uddivert/SAP-U/RAM_Module/74F189SC/SOIC16_9P9X3P9_ONS.step

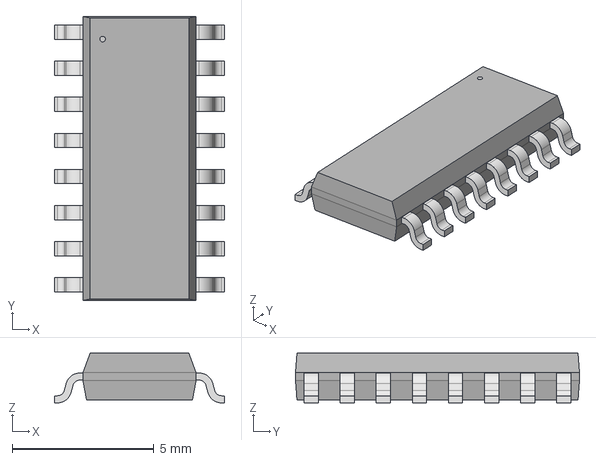
[picture p1: CAD file, 2025-08-04]
RAM_Module/74F189SC/SOIC16_9P9X3P9_ONS.step
6.00 x 10.0 x 1.75 mm
