uddivert/SAP-U/Clock_Module/Clock_Module.kicad_pcb

## KiCad design Clock_Module/Clock_Module.kicad_pcb (2025-07-19)

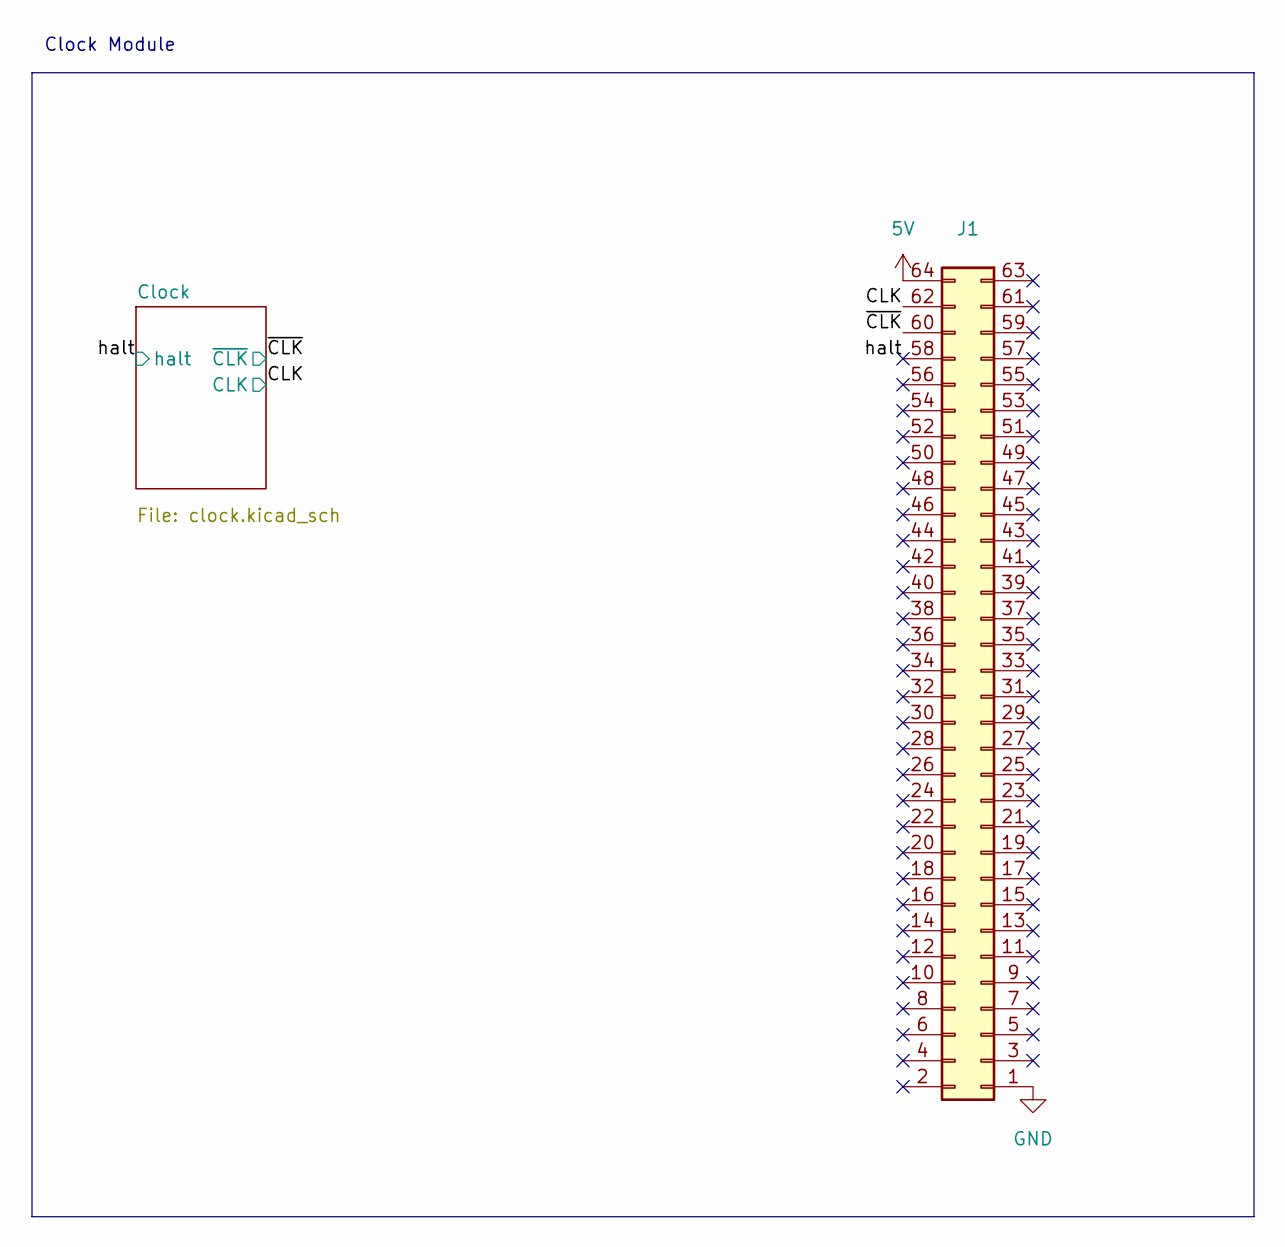
[picture p2: schematic Clock_Module.kicad_sch, Clock Module]

Parts:
J1: PC104-Standard

Connections:
5V: J1.64; also elsewhere on the board
/CLK: J1.62; also elsewhere on the board
/halt: J1.58; also elsewhere on the board
/~CLK: J1.60; also elsewhere on the board
GND: J1.1; also elsewhere on the board

Notes on the sheet:
Clock Module

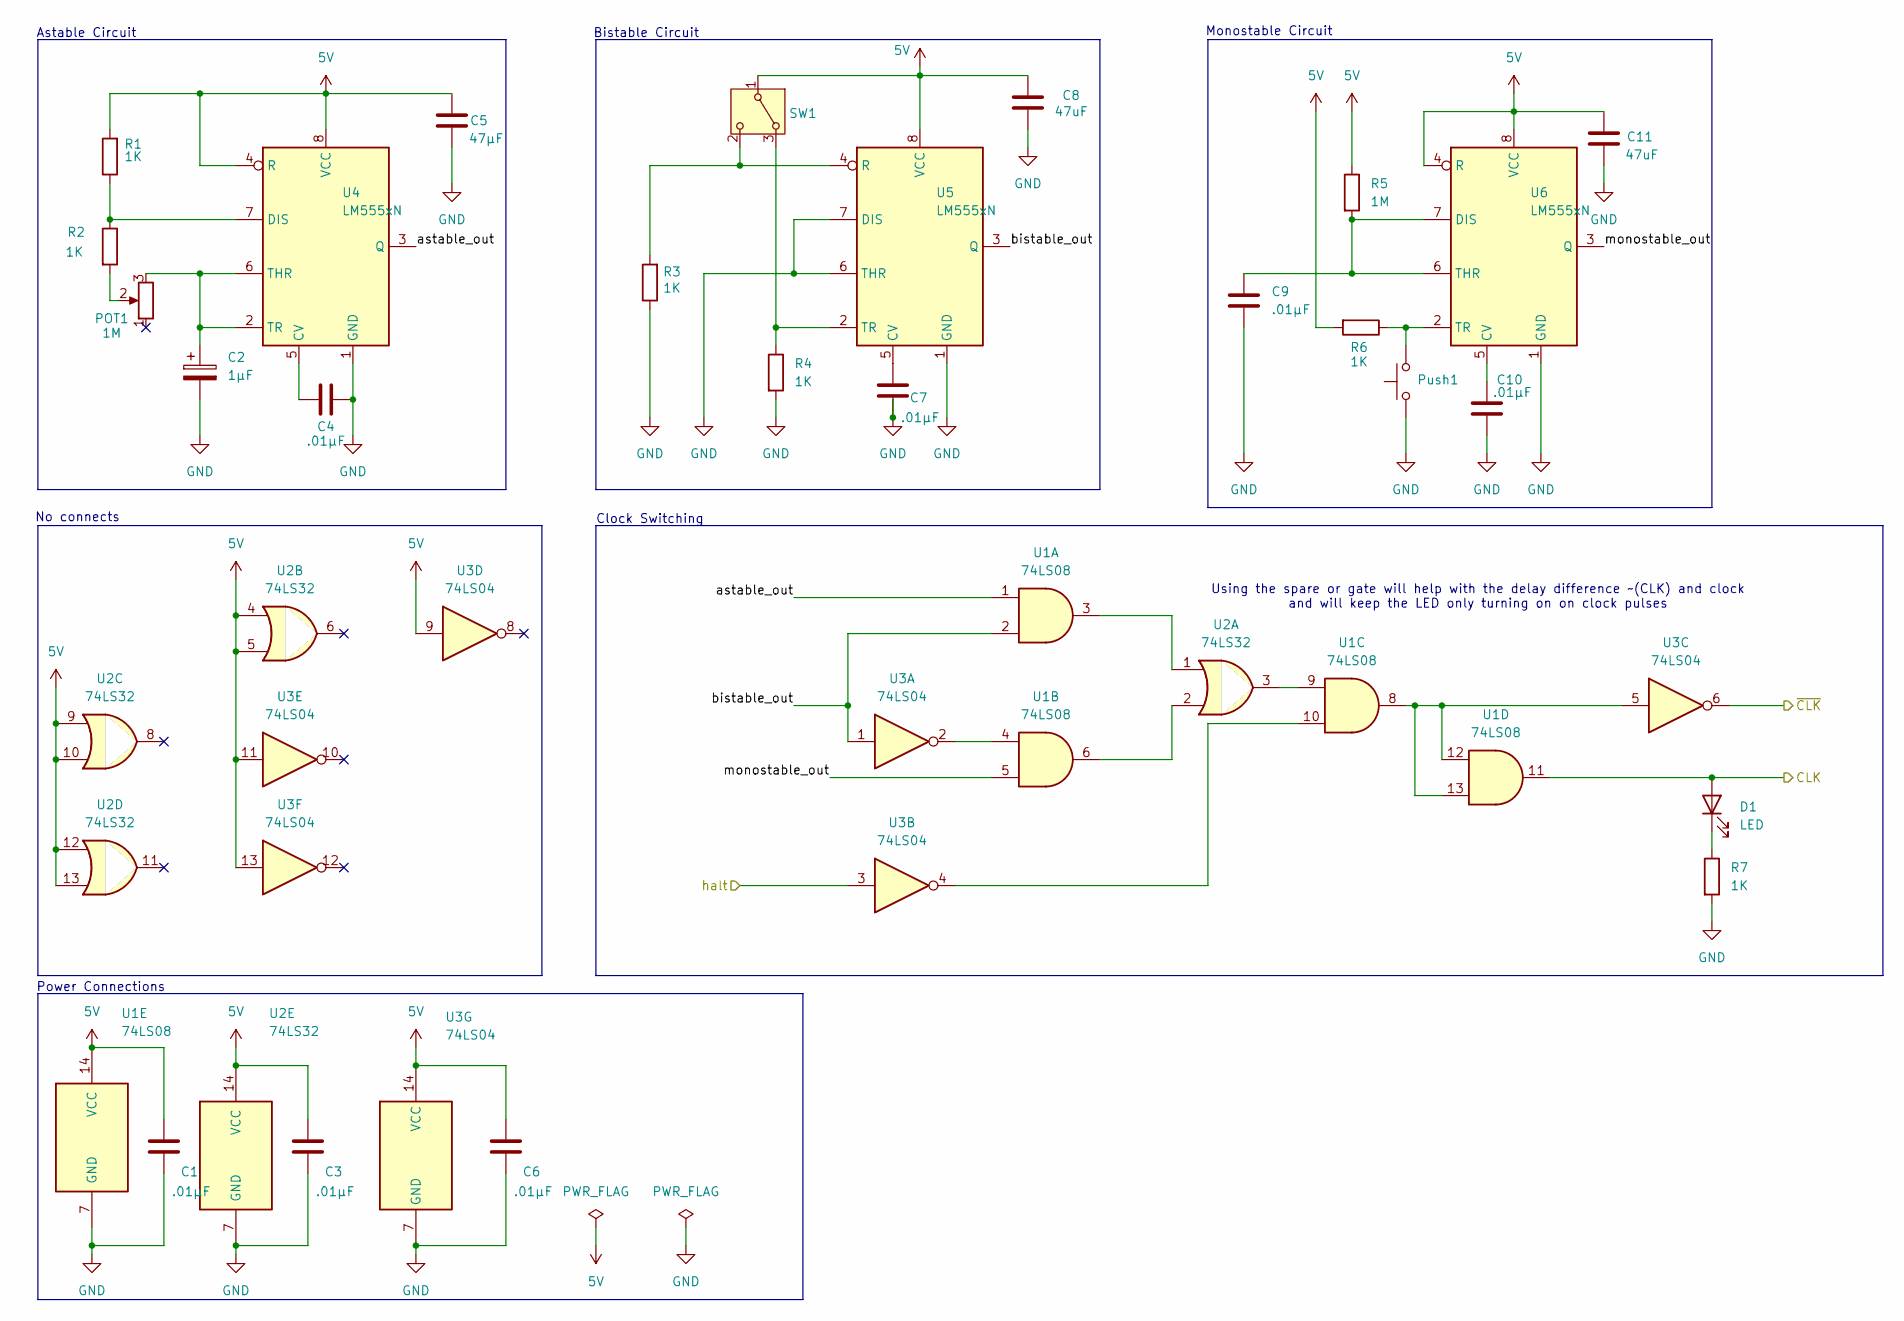
[picture p3: schematic clock.kicad_sch, Clock Logic]

Parts:
C1, C3, C4, C6, C7, C9, C10: .01µF; C_Disc_D5.0mm_W2.5mm_P2.50mm
C2: 1µF; C_Radial_D5.0mm_H11.0mm_P2.00mm
C5: 47µF; C_Disc_D5.0mm_W2.5mm_P2.50mm
C8, C11: 47uF; C_Disc_D5.0mm_W2.5mm_P2.50mm
D1: LED; LED_D5.0mm
POT1: 1M; Potentiometer_Bourns_3266Y_Vertical
Push1: SW_Push; SW_PUSH_6mm_H4.3mm
R1, R2, R3, R4, R6, R7: 1K; R_Axial_DIN0207_L6.3mm_D2.5mm_P5.08mm_Vertical
R5: 1M; R_Axial_DIN0207_L6.3mm_D2.5mm_P5.08mm_Vertical
SW1: Switch; SW_Slide-Jameco-SS-12E17-G020
U1: 74LS08; SN74LS08N
U2: 74LS32; SN74LS32N
U3: 74LS04; SN74LS04N
U4, U5, U6: LM555xN; DIP-8_W7.62mm

Connections:
5V: C1.2, C3.2, C5.1, C6.2, C8.2, C11.1, R1.2, R5.1, R6.2, SW1.1 (B), U1.14 (VCC), U2.4, U2.5, U2.9, U2.10, U2.12, U2.13, U2.14 (VCC), U3.9, U3.11, U3.13, U3.14 (VCC), U4.4 (R), U4.8 (VCC), U5.8 (VCC), U6.4 (R), U6.8 (VCC); also elsewhere on the board
/CLK: D1.2 (A), U1.11; also elsewhere on the board
/Clock/astable_out: U1.1, U4.3 (Q)
/Clock/bistable_out: U1.2, U3.1, U5.3 (Q)
/Clock/monostable_out: U1.5, U6.3 (Q)
/halt: U3.3; also elsewhere on the board
/~CLK: U3.6; also elsewhere on the board
GND: C1.1, C2.2, C3.1, C4.1, C5.2, C6.1, C7.1, C8.1, C9.1, C10.1, C11.2, Push1.1, R3.1, R4.2, R7.2, U1.7 (GND), U2.7 (GND), U3.7 (GND), U4.1 (GND), U5.1 (GND), U5.6 (THR), U5.7 (DIS), U6.1 (GND); also elsewhere on the board
unnamed: D1.1 (K), R7.1
unnamed: POT1.2, R2.2
unnamed: R4.1, SW1.3 (A), U5.2 (TR)
unnamed: R3.2, SW1.2 (C), U5.4 (R)
unnamed: U1.3, U2.1
unnamed: U1.4, U3.2
unnamed: U1.6, U2.2
unnamed: U1.9, U2.3
unnamed: U1.10, U3.4
unnamed: U1.8, U1.12, U1.13, U3.5
unnamed: C4.2, U4.5 (CV)
unnamed: R1.1, R2.1, U4.7 (DIS)
unnamed: C2.1, POT1.3, U4.2 (TR), U4.6 (THR)
unnamed: C7.2, U5.5 (CV)
unnamed: C10.2, U6.5 (CV)
unnamed: C9.2, R5.2, U6.6 (THR), U6.7 (DIS)
unnamed: Push1.2, R6.1, U6.2 (TR)

Notes on the sheet:
Astable Circuit
Power Connections
Bistable Circuit
Monostable Circuit
Clock Switching
No connects
Using the spare or gate will help with the delay difference ~(CLK) and clock and will keep the LED only turning on on clock pulses

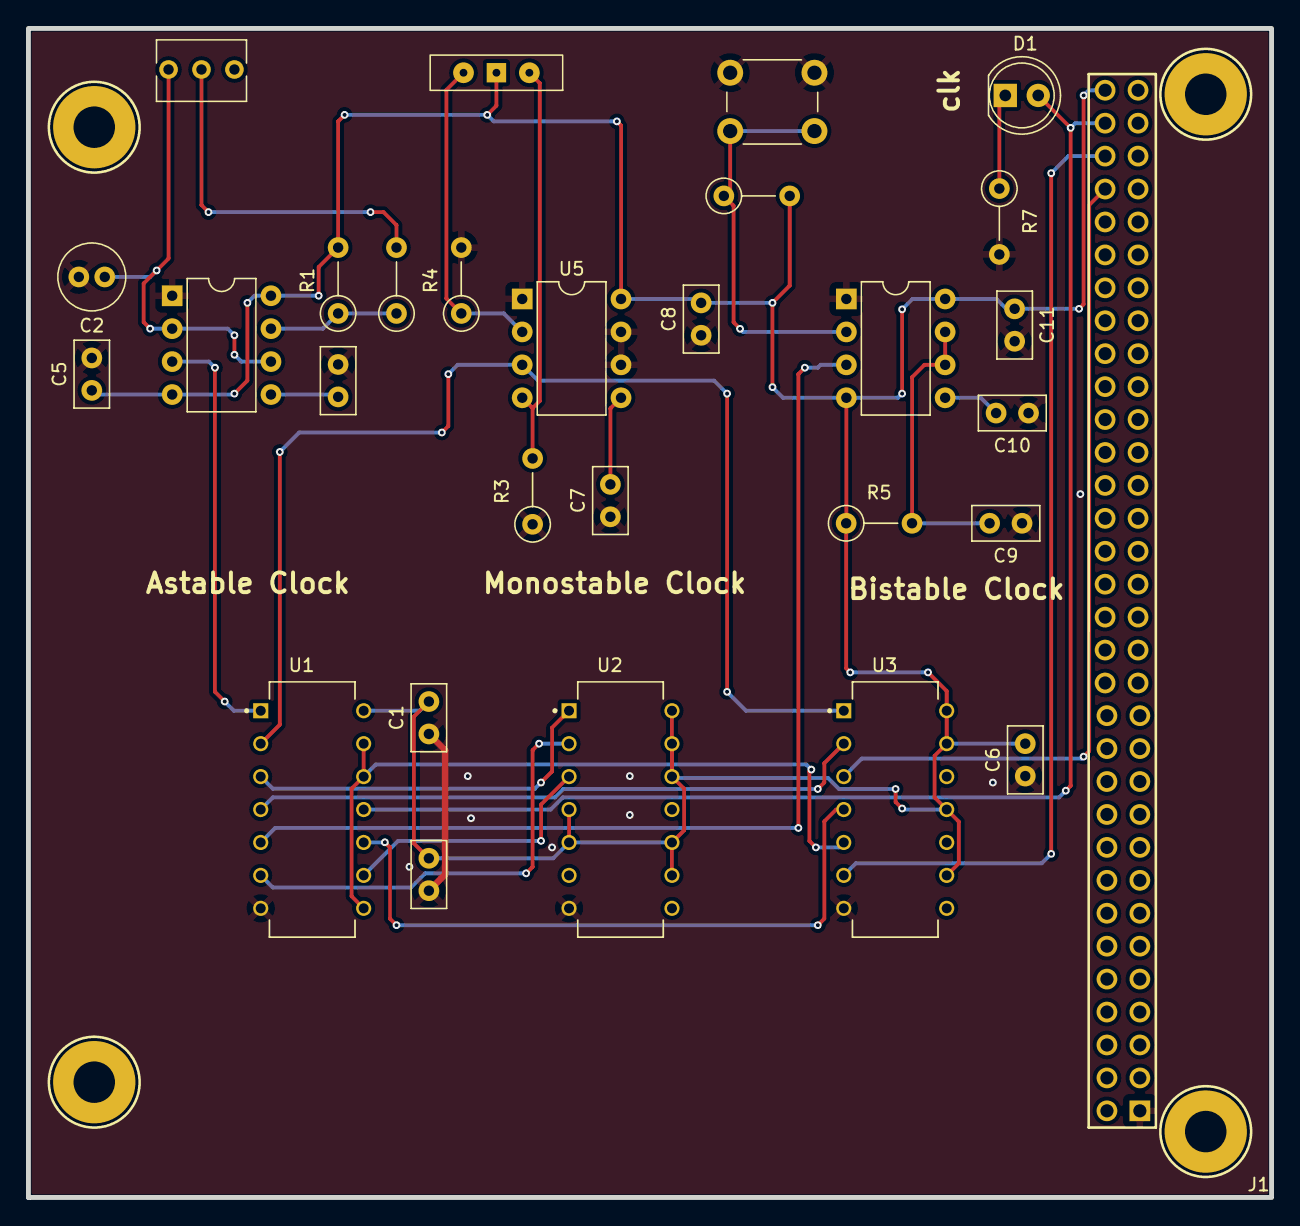
[picture p4: board Clock_Module.kicad_pcb from above]

Board: 2 copper layers, 95.9 x 90.2 mm, 29 parts (0 on the bottom side), 25 nets.
