uddivert/SAP-U/Registers_Module/Registers_Module.kicad_pcb

## KiCad design Registers_Module/Registers_Module.kicad_pcb (2025-07-19)

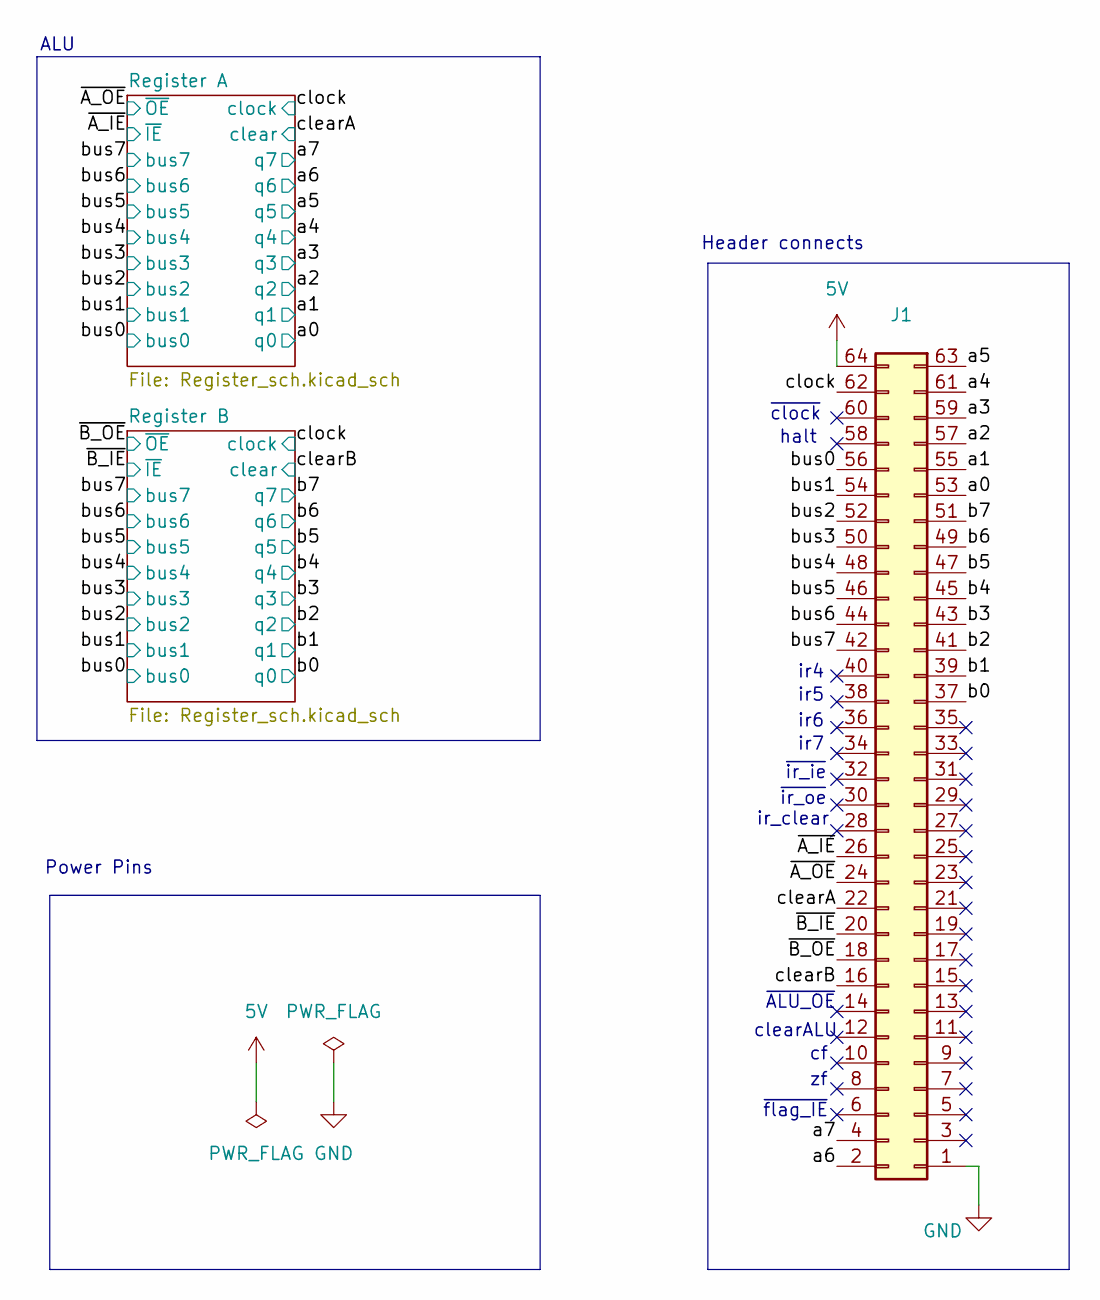
[picture p5: schematic Registers_Module.kicad_sch, Arithmethic Logic Unit]

Parts:
J1: PC104-Standard

Connections:
5V: J1.64; also elsewhere on the board
/a0: J1.53; also elsewhere on the board
/a1: J1.55; also elsewhere on the board
/a2: J1.57; also elsewhere on the board
/a3: J1.59; also elsewhere on the board
/a4: J1.61; also elsewhere on the board
/a5: J1.63; also elsewhere on the board
/a6: J1.2; also elsewhere on the board
/a7: J1.4; also elsewhere on the board
/b0: J1.37; also elsewhere on the board
/b1: J1.39; also elsewhere on the board
/b2: J1.41; also elsewhere on the board
/b3: J1.43; also elsewhere on the board
/b4: J1.45; also elsewhere on the board
/b5: J1.47; also elsewhere on the board
/b6: J1.49; also elsewhere on the board
/b7: J1.51; also elsewhere on the board
/bus0: J1.56; also elsewhere on the board
/bus1: J1.54; also elsewhere on the board
/bus2: J1.52; also elsewhere on the board
/bus3: J1.50; also elsewhere on the board
/bus4: J1.48; also elsewhere on the board
/bus5: J1.46; also elsewhere on the board
/bus6: J1.44; also elsewhere on the board
/bus7: J1.42; also elsewhere on the board
/clearA: J1.22; also elsewhere on the board
/clearB: J1.16; also elsewhere on the board
/clock: J1.62; also elsewhere on the board
/~A_IE: J1.26; also elsewhere on the board
/~A_OE: J1.24; also elsewhere on the board
/~B_IE: J1.20; also elsewhere on the board
/~B_OE: J1.18; also elsewhere on the board
GND: J1.1; also elsewhere on the board

Notes on the sheet:
ir5
ir6
~{ir_ie}
ALU
~{ir_oe}
~{ALU_OE}
ir_clear
halt
~{clock}
ir7
ir4
Header connects
Power Pins
~{flag_IE}
clearALU

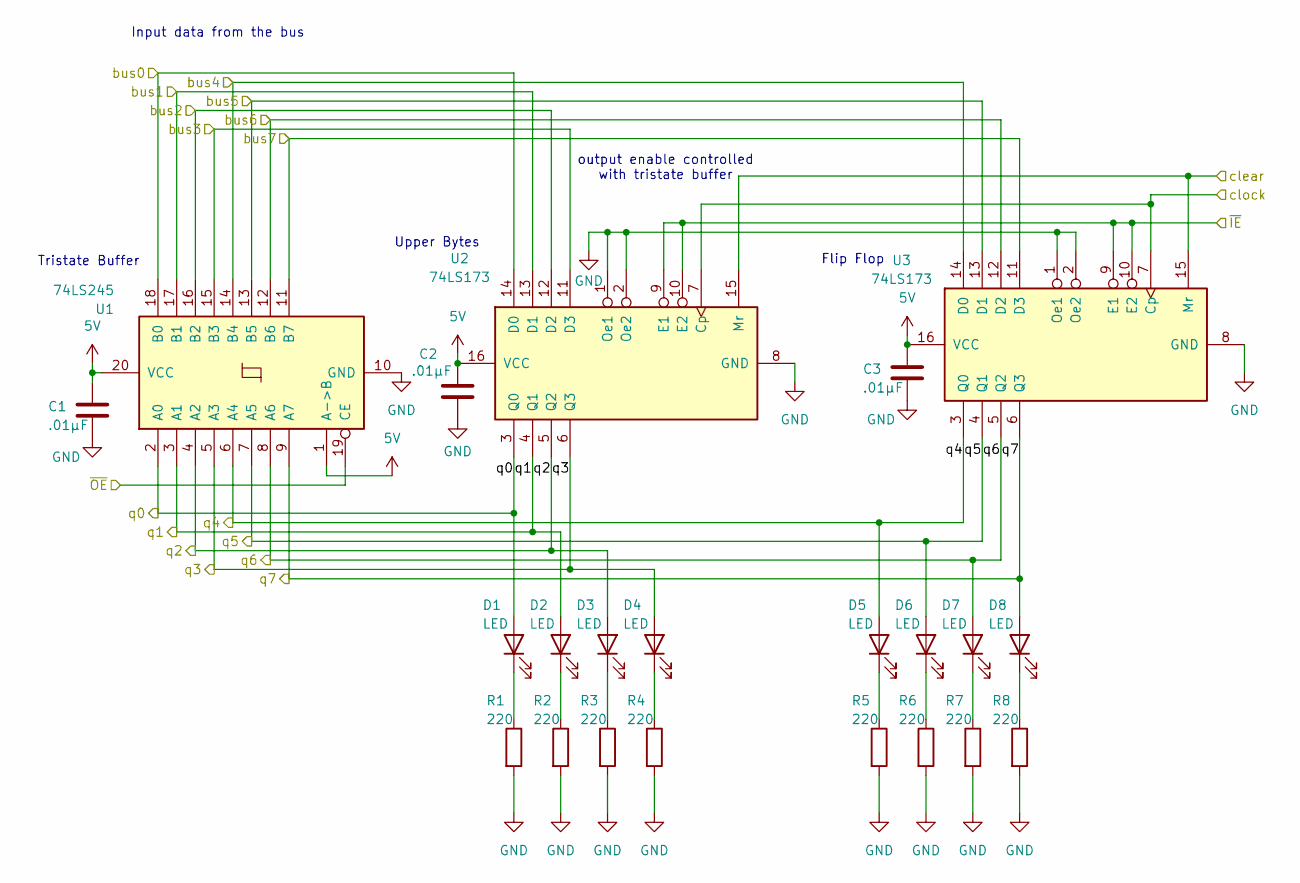
[picture p6: schematic Register_sch.kicad_sch, Registers]

Parts:
C1, C2, C3: .01µF; C_Disc_D5.0mm_W2.5mm_P2.50mm
D1, D2, D3, D4, D5, D6, D7, D8: LED; LED_D5.0mm
R1, R2, R3, R4, R5, R6, R7, R8: 220; R_Axial_DIN0207_L6.3mm_D2.5mm_P5.08mm_Vertical
U1: 74LS245; DIP-20_W7.62mm
U2, U3: 74LS173; DIP-16_W7.62mm

Connections:
5V: C1.2, C2.2, C3.2, U1.1 (A->B), U1.20 (VCC), U2.16 (VCC), U3.16 (VCC); also elsewhere on the board
/a0: D1.2 (A), U1.2 (A0), U2.3 (Q0); also elsewhere on the board
/a1: D2.2 (A), U1.3 (A1), U2.4 (Q1); also elsewhere on the board
/a2: D3.2 (A), U1.4 (A2), U2.5 (Q2); also elsewhere on the board
/a3: D4.2 (A), U1.5 (A3), U2.6 (Q3); also elsewhere on the board
/a4: D5.2 (A), U1.6 (A4), U3.3 (Q0); also elsewhere on the board
/a5: D6.2 (A), U1.7 (A5), U3.4 (Q1); also elsewhere on the board
/a6: D7.2 (A), U1.8 (A6), U3.5 (Q2); also elsewhere on the board
/a7: D8.2 (A), U1.9 (A7), U3.6 (Q3); also elsewhere on the board
/bus0: U1.18 (B0), U2.14 (D0); also elsewhere on the board
/bus1: U1.17 (B1), U2.13 (D1); also elsewhere on the board
/bus2: U1.16 (B2), U2.12 (D2); also elsewhere on the board
/bus3: U1.15 (B3), U2.11 (D3); also elsewhere on the board
/bus4: U1.14 (B4), U3.14 (D0); also elsewhere on the board
/bus5: U1.13 (B5), U3.13 (D1); also elsewhere on the board
/bus6: U1.12 (B6), U3.12 (D2); also elsewhere on the board
/bus7: U1.11 (B7), U3.11 (D3); also elsewhere on the board
/clearA: U2.15 (Mr), U3.15 (Mr); also elsewhere on the board
/clock: U2.7 (Cp), U3.7 (Cp); also elsewhere on the board
/~A_IE: U2.9 (E1), U2.10 (E2), U3.9 (E1), U3.10 (E2); also elsewhere on the board
/~A_OE: U1.19 (CE); also elsewhere on the board
GND: C1.1, C2.1, C3.1, R1.2, R2.2, R3.2, R4.2, R5.2, R6.2, R7.2, R8.2, U1.10 (GND), U2.1 (Oe1), U2.2 (Oe2), U2.8 (GND), U3.1 (Oe1), U3.2 (Oe2), U3.8 (GND); also elsewhere on the board
unnamed: D1.1 (K), R1.1
unnamed: D2.1 (K), R2.1
unnamed: D3.1 (K), R3.1
unnamed: D4.1 (K), R4.1
unnamed: D5.1 (K), R5.1
unnamed: D6.1 (K), R6.1
unnamed: D7.1 (K), R7.1
unnamed: D8.1 (K), R8.1

Parts of its further copies:
C12, C13, C14: .01µF; C_Disc_D5.0mm_W2.5mm_P2.50mm
D17, D18, D19, D20, D21, D22, D23, D24: LED; LED_D5.0mm
R17, R18, R19, R20, R21, R22, R23, R24: 220; R_Axial_DIN0207_L6.3mm_D2.5mm_P5.08mm_Vertical
U12: 74LS245; DIP-20_W7.62mm
U13, U14: 74LS173; DIP-16_W7.62mm

Connections of its further copies:
5V: C12.2, C13.2, C14.2, U12.1 (A->B), U12.20 (VCC), U13.16 (VCC), U14.16 (VCC); also elsewhere on the board
/b0: D17.2 (A), U12.2 (A0), U13.3 (Q0); also elsewhere on the board
/b1: D18.2 (A), U12.3 (A1), U13.4 (Q1); also elsewhere on the board
/b2: D19.2 (A), U12.4 (A2), U13.5 (Q2); also elsewhere on the board
/b3: D20.2 (A), U12.5 (A3), U13.6 (Q3); also elsewhere on the board
/b4: D21.2 (A), U12.6 (A4), U14.3 (Q0); also elsewhere on the board
/b5: D22.2 (A), U12.7 (A5), U14.4 (Q1); also elsewhere on the board
/b6: D23.2 (A), U12.8 (A6), U14.5 (Q2); also elsewhere on the board
/b7: D24.2 (A), U12.9 (A7), U14.6 (Q3); also elsewhere on the board
/bus0: U12.18 (B0), U13.14 (D0); also elsewhere on the board
/bus1: U12.17 (B1), U13.13 (D1); also elsewhere on the board
/bus2: U12.16 (B2), U13.12 (D2); also elsewhere on the board
/bus3: U12.15 (B3), U13.11 (D3); also elsewhere on the board
/bus4: U12.14 (B4), U14.14 (D0); also elsewhere on the board
/bus5: U12.13 (B5), U14.13 (D1); also elsewhere on the board
/bus6: U12.12 (B6), U14.12 (D2); also elsewhere on the board
/bus7: U12.11 (B7), U14.11 (D3); also elsewhere on the board
/clearB: U13.15 (Mr), U14.15 (Mr); also elsewhere on the board
/clock: U13.7 (Cp), U14.7 (Cp); also elsewhere on the board
/~B_IE: U13.9 (E1), U13.10 (E2), U14.9 (E1), U14.10 (E2); also elsewhere on the board
/~B_OE: U12.19 (CE); also elsewhere on the board
GND: C12.1, C13.1, C14.1, R17.2, R18.2, R19.2, R20.2, R21.2, R22.2, R23.2, R24.2, U12.10 (GND), U13.1 (Oe1), U13.2 (Oe2), U13.8 (GND), U14.1 (Oe1), U14.2 (Oe2), U14.8 (GND); also elsewhere on the board
unnamed: D17.1 (K), R17.1
unnamed: D18.1 (K), R18.1
unnamed: D19.1 (K), R19.1
unnamed: D20.1 (K), R20.1
unnamed: D21.1 (K), R21.1
unnamed: D22.1 (K), R22.1
unnamed: D23.1 (K), R23.1
unnamed: D24.1 (K), R24.1

Notes on the sheet:
Upper Bytes
Flip Flop
output enable controlled with tristate buffer
Input data from the bus
Tristate Buffer

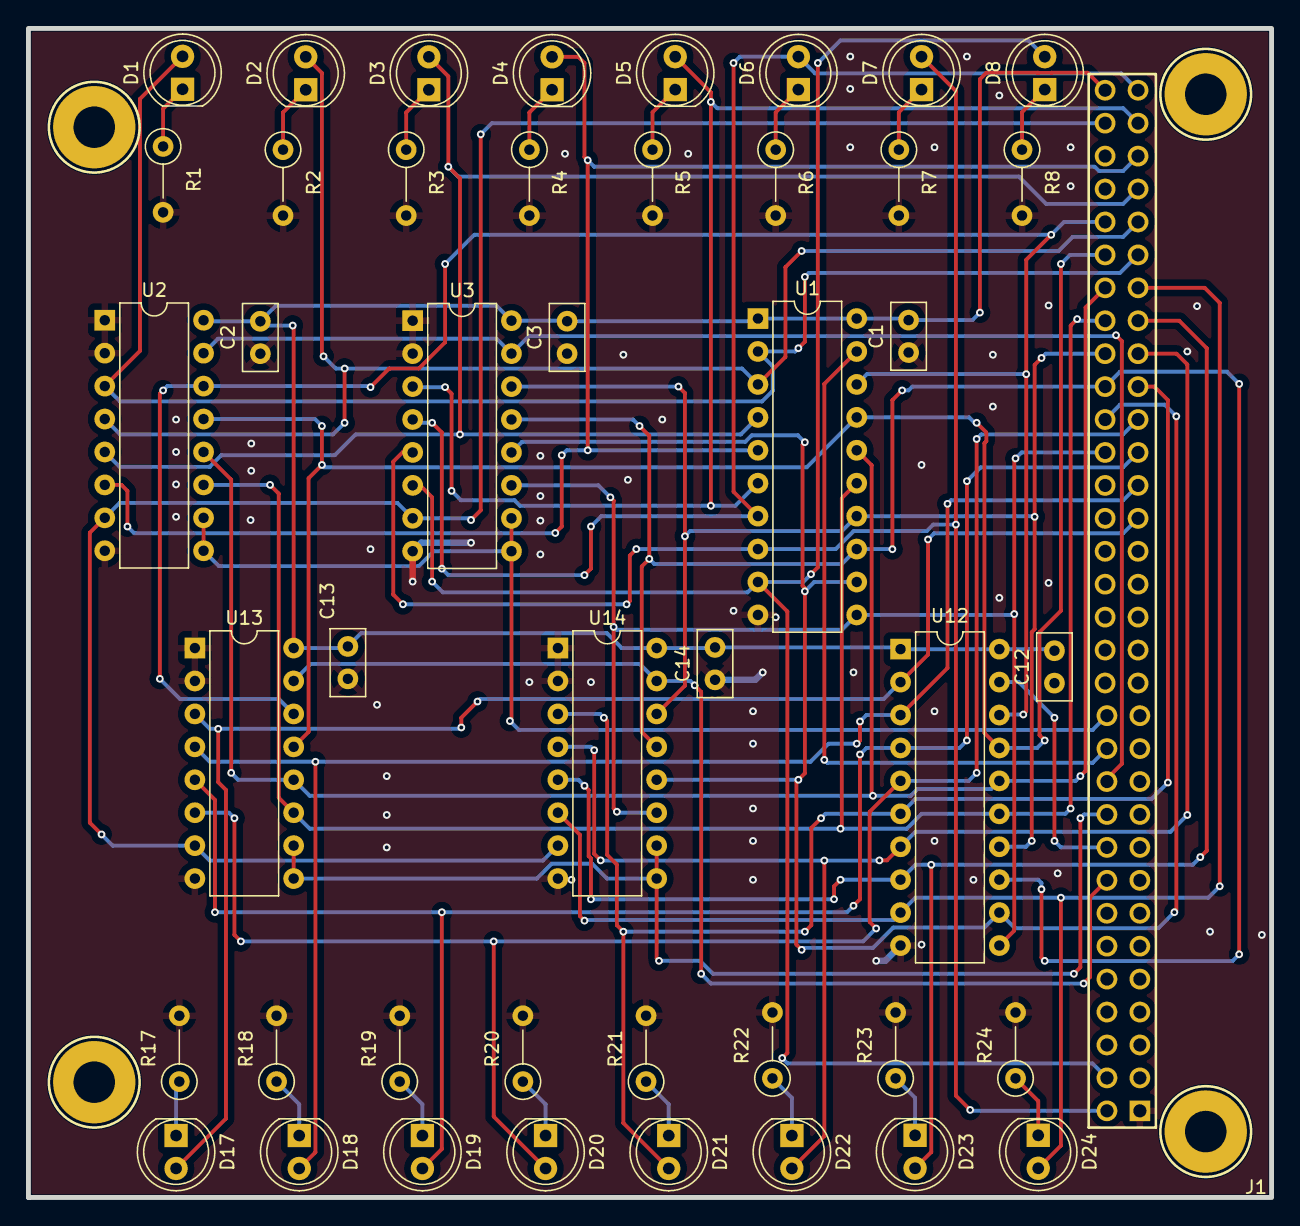
[picture p7: board Registers_Module.kicad_pcb from above]

Board: 2 copper layers, 95.9 x 90.2 mm, 45 parts (0 on the bottom side), 49 nets.
