uddivert/SAP-U/Instruction_Register/Instruction_Register.kicad_pcb

## KiCad design Instruction_Register/Instruction_Register.kicad_pcb (2025-02-03)

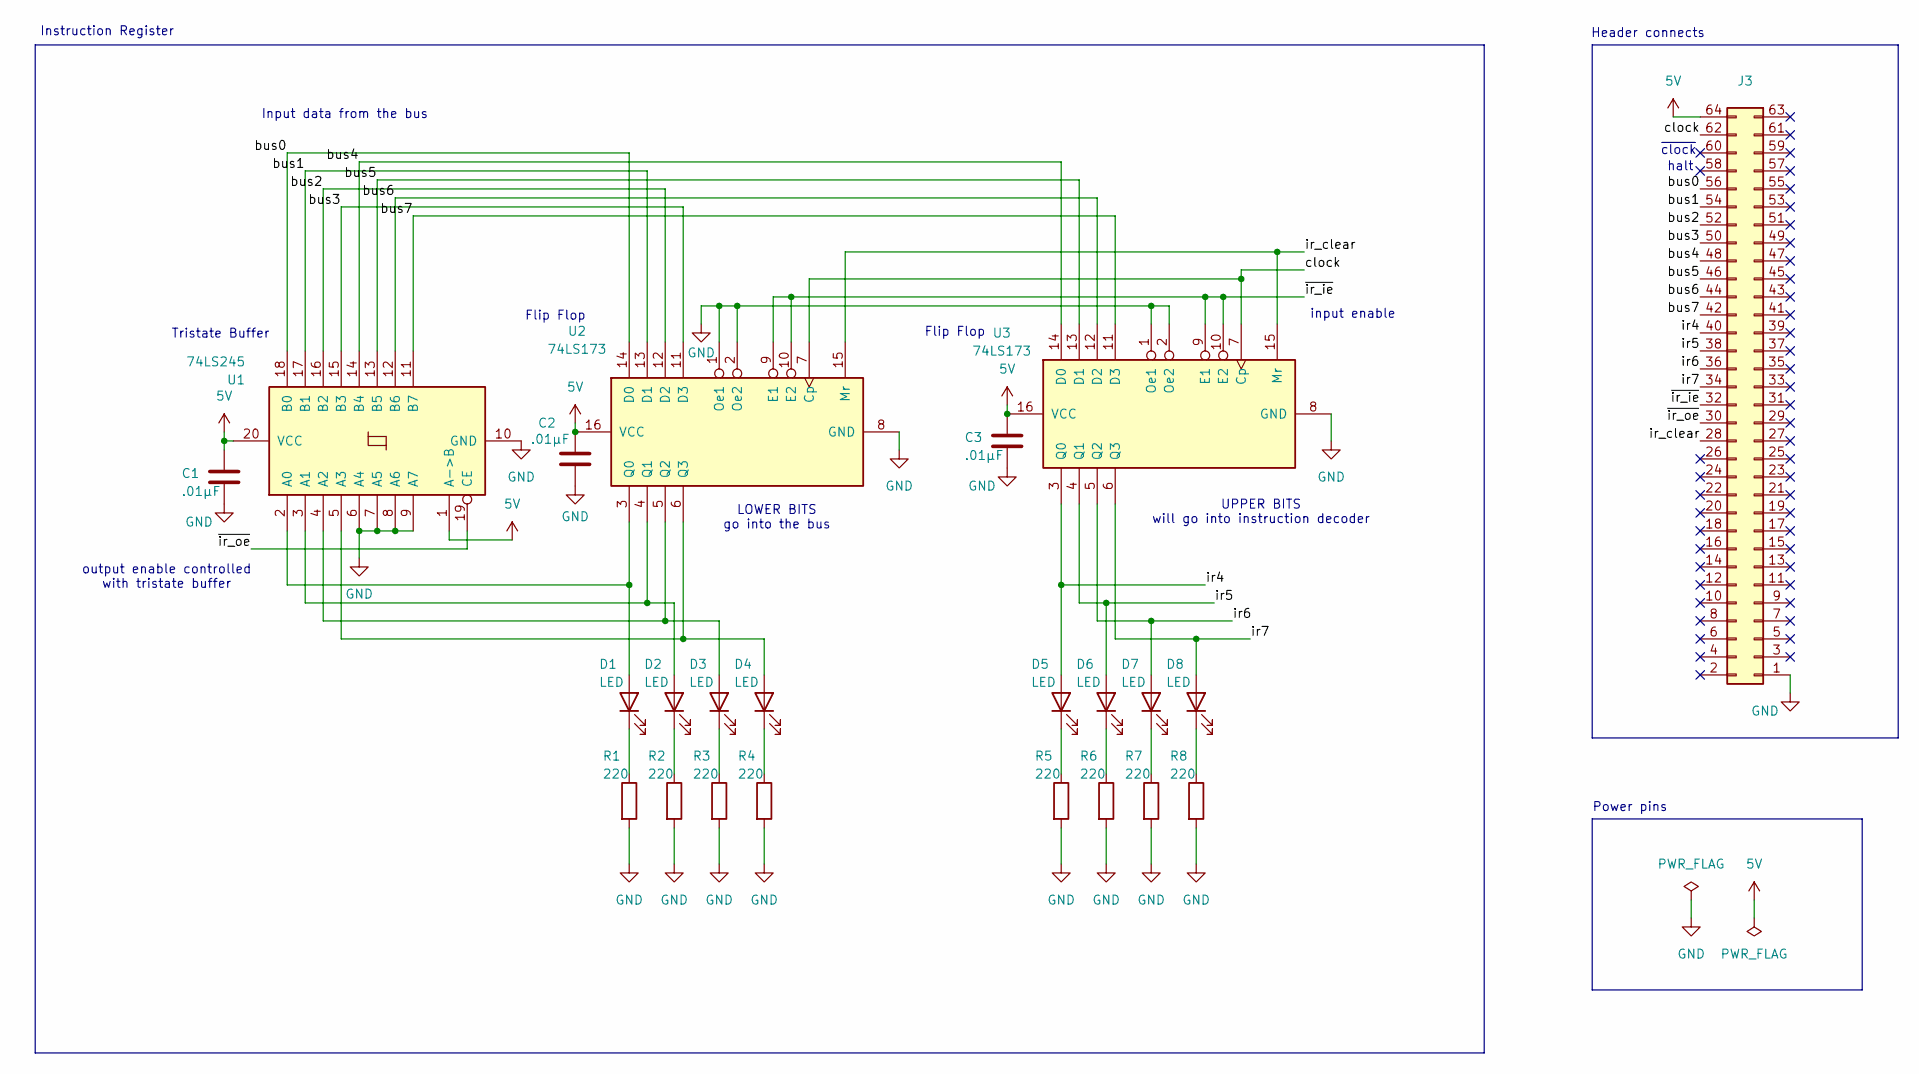
[picture p8: schematic Instruction_Register.kicad_sch, Instruction Register]

Parts:
C1, C2, C3: .01µF; C_Disc_D5.0mm_W2.5mm_P2.50mm
D1, D2, D3, D4, D5, D6, D7, D8: LED; LED_D5.0mm
J3: PC104-Standard
R1, R2, R3, R4, R5, R6, R7, R8: 220; R_Axial_DIN0207_L6.3mm_D2.5mm_P5.08mm_Vertical
U1: 74LS245; DIP-20_W7.62mm
U2, U3: 74LS173; DIP-16_W7.62mm

Connections:
5V: C1.2, C2.2, C3.2, J3.64, U1.1 (A->B), U1.20 (VCC), U2.16 (VCC), U3.16 (VCC)
/bus0: J3.56, U1.18 (B0), U2.14 (D0)
/bus1: J3.54, U1.17 (B1), U2.13 (D1)
/bus2: J3.52, U1.16 (B2), U2.12 (D2)
/bus3: J3.50, U1.15 (B3), U2.11 (D3)
/bus4: J3.48, U1.14 (B4), U3.14 (D0)
/bus5: J3.46, U1.13 (B5), U3.13 (D1)
/bus6: J3.44, U1.12 (B6), U3.12 (D2)
/bus7: J3.42, U1.11 (B7), U3.11 (D3)
/clock: J3.62, U2.7 (Cp), U3.7 (Cp)
/ir4: D5.2 (A), J3.40, U3.3 (Q0)
/ir5: D6.2 (A), J3.38, U3.4 (Q1)
/ir6: D7.2 (A), J3.36, U3.5 (Q2)
/ir7: D8.2 (A), J3.34, U3.6 (Q3)
/ir_clear: J3.28, U2.15 (Mr), U3.15 (Mr)
/~ir_ie: J3.32, U2.9 (E1), U2.10 (E2), U3.9 (E1), U3.10 (E2)
/~ir_oe: J3.30, U1.19 (CE)
GND: C1.1, C2.1, C3.1, J3.1, R1.2, R2.2, R3.2, R4.2, R5.2, R6.2, R7.2, R8.2, U1.6 (A4), U1.7 (A5), U1.8 (A6), U1.9 (A7), U1.10 (GND), U2.1 (Oe1), U2.2 (Oe2), U2.8 (GND), U3.1 (Oe1), U3.2 (Oe2), U3.8 (GND)
unnamed: D1.2 (A), U1.2 (A0), U2.3 (Q0)
unnamed: D1.1 (K), R1.1
unnamed: D2.2 (A), U1.3 (A1), U2.4 (Q1)
unnamed: D2.1 (K), R2.1
unnamed: D3.2 (A), U1.4 (A2), U2.5 (Q2)
unnamed: D3.1 (K), R3.1
unnamed: D4.2 (A), U1.5 (A3), U2.6 (Q3)
unnamed: D4.1 (K), R4.1
unnamed: D5.1 (K), R5.1
unnamed: D6.1 (K), R6.1
unnamed: D7.1 (K), R7.1
unnamed: D8.1 (K), R8.1

Notes on the sheet:
UPPER BITS will go into instruction decoder
input enable
Flip Flop
Instruction Register
Power pins
~{clock}
Header connects
halt
output enable controlled with tristate buffer
LOWER BITS go into the bus
Input data from the bus
Tristate Buffer

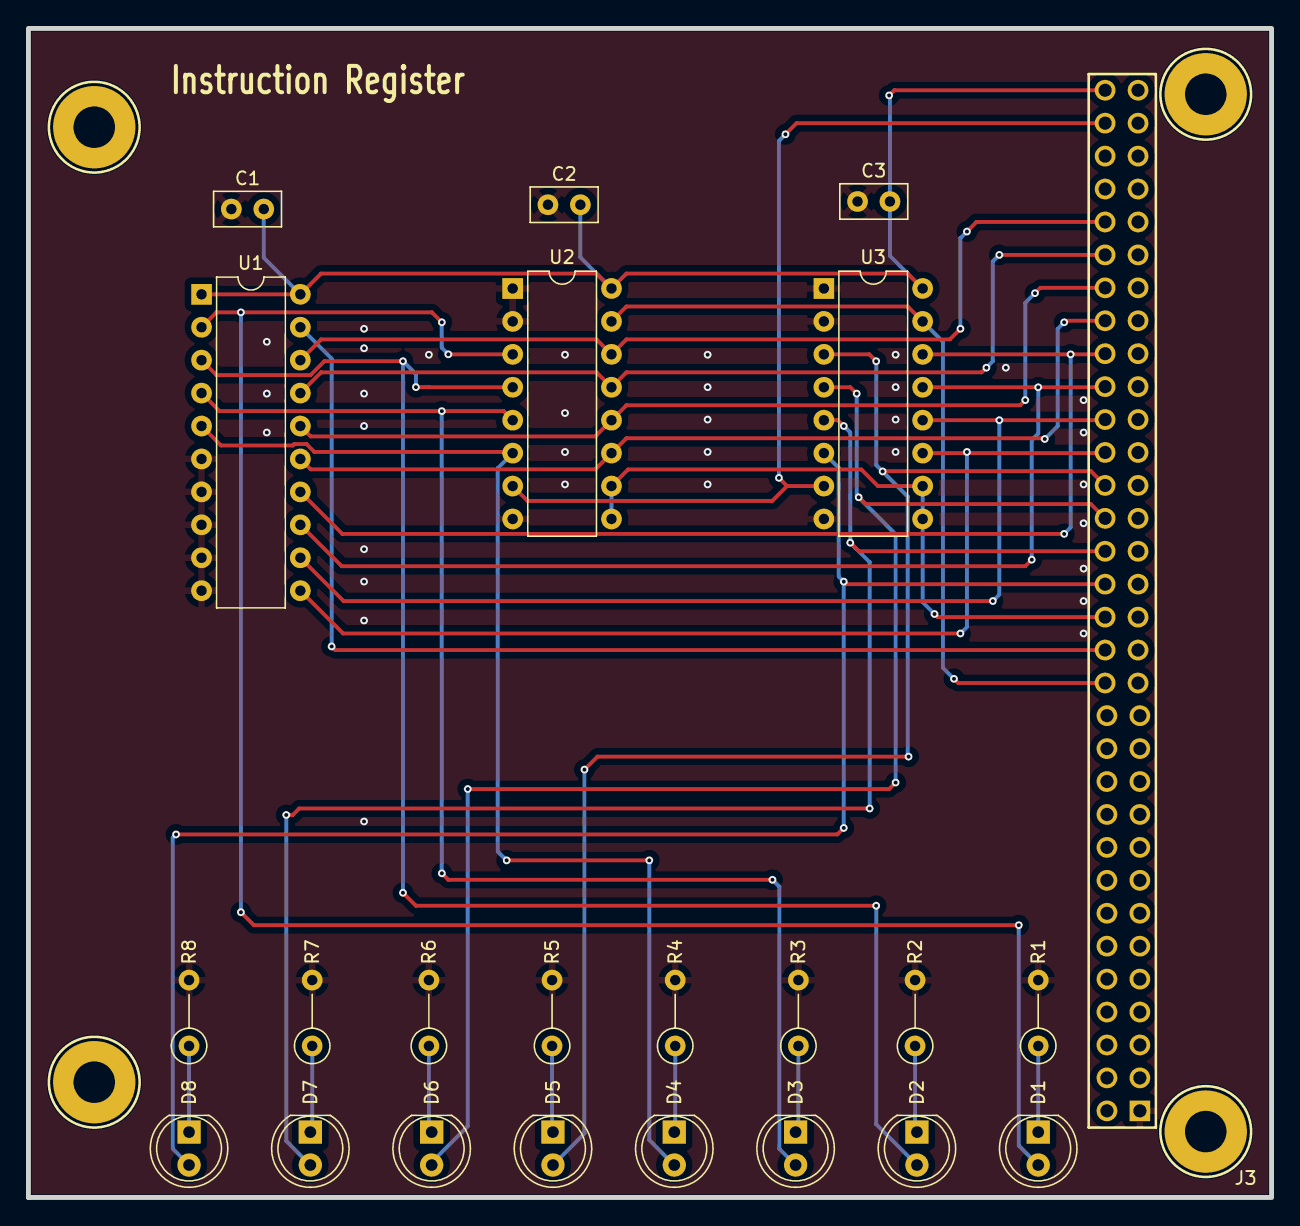
[picture p9: board Instruction_Register.kicad_pcb from above]

Board: 2 copper layers, 95.9 x 90.2 mm, 23 parts (0 on the bottom side), 30 nets.
