uddivert/SAP-U/Arithmetic_Logic_Unit/Arithmetic_Logic_Unit.kicad_pcb

## KiCad design Arithmetic_Logic_Unit/Arithmetic_Logic_Unit.kicad_pcb (2025-02-03)

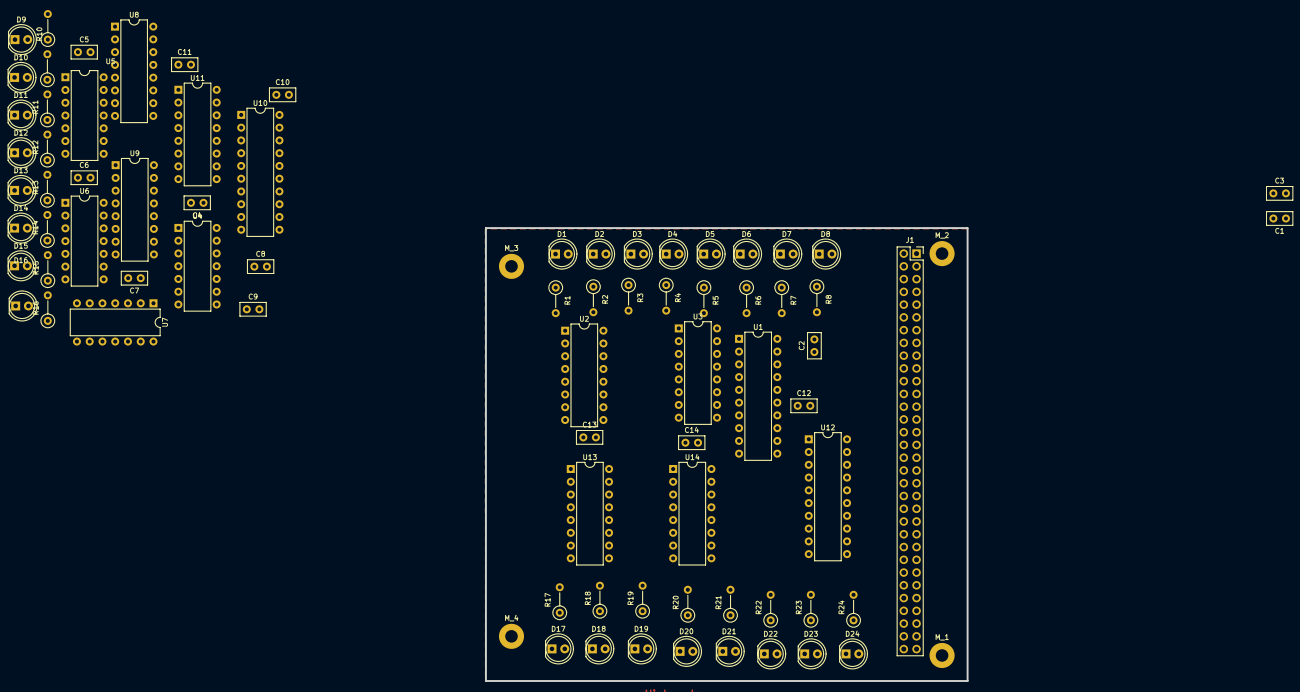
[picture p10: board Arithmetic_Logic_Unit.kicad_pcb from above]

Board: 2 copper layers, 95.9 x 90.2 mm, 81 parts (0 on the bottom side), 88 nets, no tracks yet.

Parts:
C1, C2, C3, C4, C5, C6, C7, C8, C9, C10, C11, C12, C13, C14: .01µF; C_Disc_D5.0mm_W2.5mm_P2.50mm
D1, D2, D3, D4, D5, D6, D7, D8, D9, D10, D11, D12, D13, D14, D15, D16, D17, D18, D19, D20, D21, D22, D23, D24: LED; LED_D5.0mm
J1: PC104; PinSocket_2x32_P2.54mm_Vertical
M_1, M_2, M_3, M_4: MountingHole_2.5mm_Pad
R1, R2, R3, R4, R5, R6, R7, R8, R9, R10, R11, R12, R13, R14, R15, R16, R17, R18, R19, R20, R21, R22, R23, R24: 220; R_Axial_DIN0207_L6.3mm_D2.5mm_P5.08mm_Vertical
U1, U10, U12: 74LS245; DIP-20_W7.62mm
U2, U3, U11, U13, U14: 74LS173; DIP-16_W7.62mm
U4: 74LS08; DIP-14_W7.62mm
U5, U6: 74LS86; DIP-14_W7.62mm
U7: 74LS02; DIP-14_W7.62mm
U8, U9: 74LS283; DIP-16_W7.62mm

Connections:
5V: C1.2, C2.2, C3.2, C4.2, C5.2, C6.2, C7.2, C8.2, C9.2, C10.2, C11.2, C12.2, C13.2, C14.2, J1.36, J1.62, U1.1 (A->B), U1.20 (VCC), U2.16 (VCC), U3.16 (VCC), U4.14 (VCC), U5.14 (VCC), U6.14 (VCC), U7.14 (VCC), U8.16 (VCC), U9.16 (VCC), U10.1 (A->B), U10.20 (VCC), U11.16 (VCC), U12.1 (A->B), U12.20 (VCC), U13.16 (VCC), U14.16 (VCC)
/ALU/a0: D1.2 (A), U1.2 (A0), U2.3 (Q0), U9.12 (A4)
/ALU/a1: D2.2 (A), U1.3 (A1), U2.4 (Q1), U9.14 (A3)
/ALU/a2: D3.2 (A), U1.4 (A2), U2.5 (Q2), U9.3 (A2)
/ALU/a3: D4.2 (A), U1.5 (A3), U2.6 (Q3), U9.5 (A1)
/ALU/a4: D5.2 (A), U1.6 (A4), U3.3 (Q0), U8.12 (A4)
/ALU/a5: D6.2 (A), U1.7 (A5), U3.4 (Q1), U8.14 (A3)
/ALU/a6: D7.2 (A), U1.8 (A6), U3.5 (Q2), U8.3 (A2)
/ALU/a7: D8.2 (A), U1.9 (A7), U3.6 (Q3), U8.5 (A1)
/ALU/b0: D17.2 (A), U6.12, U12.2 (A0), U13.3 (Q0)
/ALU/b1: D18.2 (A), U6.9, U12.3 (A1), U13.4 (Q1)
/ALU/b2: D19.2 (A), U6.4, U12.4 (A2), U13.5 (Q2)
/ALU/b3: D20.2 (A), U6.1, U12.5 (A3), U13.6 (Q3)
/ALU/b4: D21.2 (A), U5.12, U12.6 (A4), U14.3 (Q0)
/ALU/b5: D22.2 (A), U5.9, U12.7 (A5), U14.4 (Q1)
/ALU/b6: D23.2 (A), U5.4, U12.8 (A6), U14.5 (Q2)
/ALU/b7: D24.2 (A), U5.1, U12.9 (A7), U14.6 (Q3)
/ALU/carry_connector: U8.7 (C0), U9.9 (C4)
/ALU/s0: D9.2 (A), U7.12, U9.10 (S4), U10.9 (A7)
/ALU/s1: D10.2 (A), U7.11, U9.13 (S3), U10.8 (A6)
/ALU/s2: D11.2 (A), U7.9, U9.1 (S2), U10.7 (A5)
/ALU/s3: D12.2 (A), U7.8, U9.4 (S1), U10.6 (A4)
/ALU/s4: D13.2 (A), U7.6, U8.10 (S4), U10.5 (A3)
/ALU/s5: D14.2 (A), U7.5, U8.13 (S3), U10.4 (A2)
/ALU/s6: D15.2 (A), U7.3, U8.1 (S2), U10.3 (A1)
/ALU/s7: D16.2 (A), U7.2, U8.4 (S1), U10.2 (A0)
/ALU/~b0: U6.11, U9.11 (B4)
/ALU/~b1: U6.8, U9.15 (B3)
/ALU/~b2: U6.6, U9.2 (B2)
/ALU/~b3: U6.3, U9.6 (B1)
/ALU/~b4: U5.11, U8.11 (B4)
/ALU/~b5: U5.8, U8.15 (B3)
/ALU/~b6: U5.6, U8.2 (B2)
/ALU/~b7: U5.3, U8.6 (B1)
/bus0: J1.9, U1.18 (B0), U2.14 (D0), U10.11 (B7), U12.18 (B0), U13.14 (D0)
/bus1: J1.8, U1.17 (B1), U2.13 (D1), U10.12 (B6), U12.17 (B1), U13.13 (D1)
/bus2: J1.7, U1.16 (B2), U2.12 (D2), U10.13 (B5), U12.16 (B2), U13.12 (D2)
/bus3: J1.6, U1.15 (B3), U2.11 (D3), U10.14 (B4), U12.15 (B3), U13.11 (D3)
/bus4: J1.5, U1.14 (B4), U3.14 (D0), U10.15 (B3), U12.14 (B4), U14.14 (D0)
/bus5: J1.4, U1.13 (B5), U3.13 (D1), U10.16 (B2), U12.13 (B5), U14.13 (D1)
/bus6: J1.3, U1.12 (B6), U3.12 (D2), U10.17 (B1), U12.12 (B6), U14.12 (D2)
/bus7: J1.2, U1.11 (B7), U3.11 (D3), U10.18 (B0), U12.11 (B7), U14.11 (D3)
/cf: J1.17, U11.3 (Q0)
/clear: J1.19, U11.15 (Mr)
/clearA: J1.15, U2.15 (Mr), U3.15 (Mr)
/clearB: J1.16, U13.15 (Mr), U14.15 (Mr)
/clock: J1.45, U2.7 (Cp), U3.7 (Cp), U11.7 (Cp), U13.7 (Cp), U14.7 (Cp)
/en_sub: J1.13, U5.2, U5.5, U5.10, U5.13, U6.2, U6.5, U6.10, U6.13, U9.7 (C0)
/fi: J1.20, U11.9 (E1), U11.10 (E2)
/zf: J1.18, U11.4 (Q1)
/~ALU_OE: J1.28, U10.19 (CE)
/~A_IE: J1.26, U2.9 (E1), U2.10 (E2), U3.9 (E1), U3.10 (E2)
/~A_OE: J1.31, U1.19 (CE)
/~B_IE: J1.27, U13.9 (E1), U13.10 (E2), U14.9 (E1), U14.10 (E2)
/~B_OE: J1.30, U12.19 (CE)
GND: C1.1, C2.1, C3.1, C4.1, C5.1, C6.1, C7.1, C8.1, C9.1, C10.1, C11.1, C12.1, C13.1, C14.1, J1.32, J1.33, J1.34, J1.64, M_1.1, M_2.1, M_3.1, M_4.1, R1.2, R2.2, R3.2, R4.2, R5.2, R6.2, R7.2, R8.2, R9.2, R10.2, R11.2, R12.2, R13.2, R14.2, R15.2, R16.2, R17.2, R18.2, R19.2, R20.2, R21.2, R22.2, R23.2, R24.2, U1.10 (GND), U2.1 (Oe1), U2.2 (Oe2), U2.8 (GND), U3.1 (Oe1), U3.2 (Oe2), U3.8 (GND), U4.7 (GND), U4.12, U4.13, U5.7 (GND), U6.7 (GND), U7.7 (GND), U8.8 (GND), U9.8 (GND), U10.10 (GND), U11.1 (Oe1), U11.2 (Oe2), U11.8 (GND), U12.10 (GND), U13.1 (Oe1), U13.2 (Oe2), U13.8 (GND), U14.1 (Oe1), U14.2 (Oe2), U14.8 (GND)
unnamed: D1.1 (K), R1.1
unnamed: D2.1 (K), R2.1
unnamed: D3.1 (K), R3.1
unnamed: D4.1 (K), R4.1
unnamed: D5.1 (K), R5.1
unnamed: D6.1 (K), R6.1
unnamed: D7.1 (K), R7.1
unnamed: D8.1 (K), R8.1
unnamed: D9.1 (K), R9.1
unnamed: D10.1 (K), R10.1
unnamed: D11.1 (K), R11.1
unnamed: D12.1 (K), R12.1
unnamed: D13.1 (K), R13.1
unnamed: D14.1 (K), R14.1
unnamed: D15.1 (K), R15.1
unnamed: D16.1 (K), R16.1
unnamed: D17.1 (K), R17.1
unnamed: D18.1 (K), R18.1
unnamed: D19.1 (K), R19.1
unnamed: D20.1 (K), R20.1
unnamed: D21.1 (K), R21.1
unnamed: D22.1 (K), R22.1
unnamed: D23.1 (K), R23.1
unnamed: D24.1 (K), R24.1
unnamed: U4.1, U7.1
unnamed: U4.2, U7.4
unnamed: U4.3, U4.9
unnamed: U4.4, U7.10
unnamed: U4.5, U7.13
unnamed: U4.6, U4.10
unnamed: U8.9 (C4), U11.14 (D0)
unnamed: U4.8, U11.13 (D1)
