uddivert/SAP-U/Sim/Schematic_Sims/555TimerModel.kicad_sch

## KiCad design Sim/Schematic_Sims/555TimerModel.kicad_sch (2024-10-01)

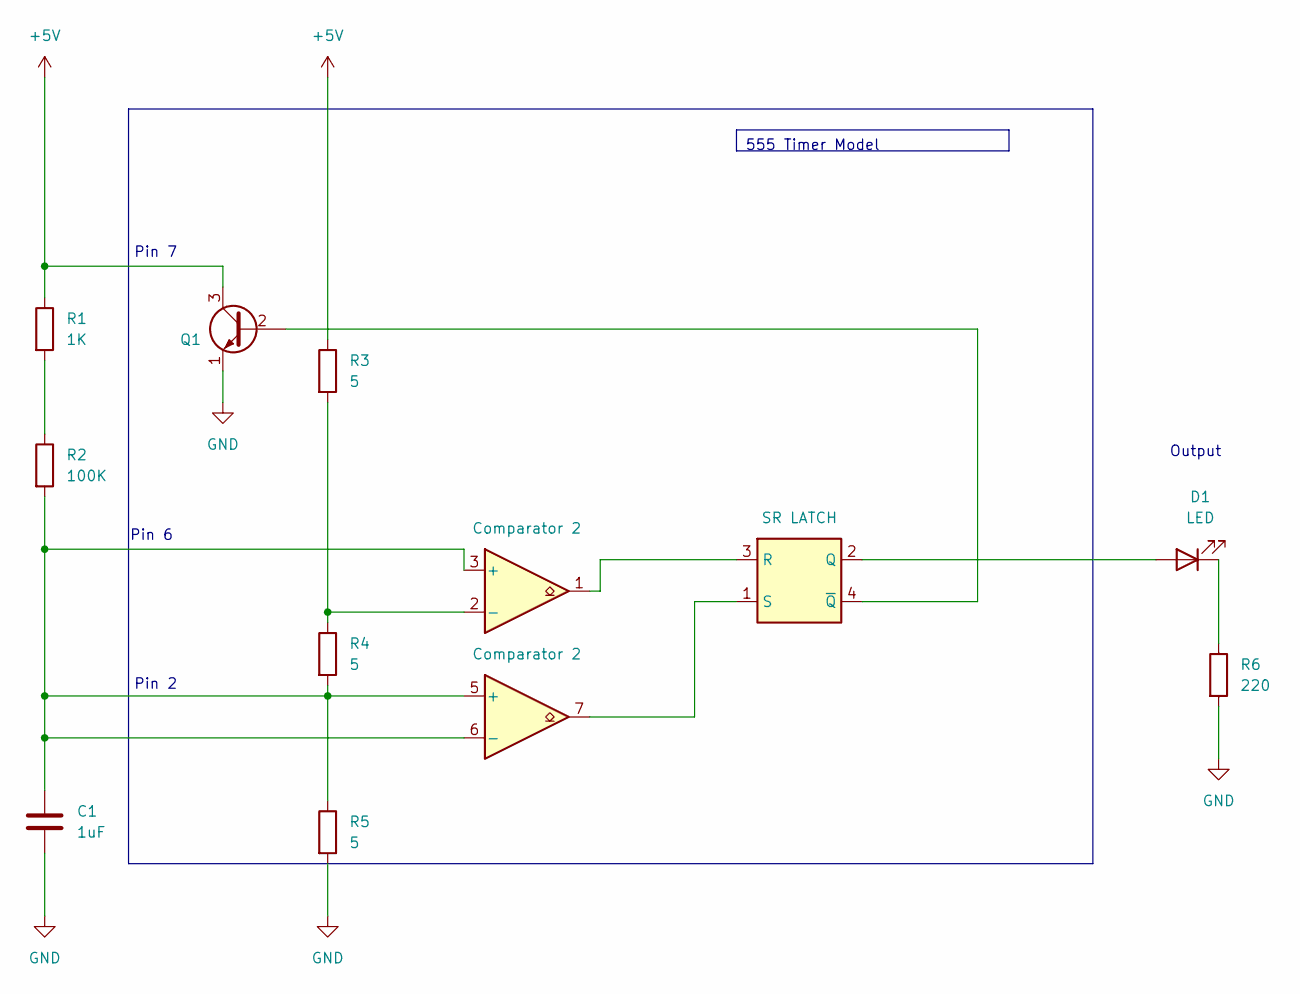
[picture p11: schematic 555TimerModel.kicad_sch]

Parts:
C1: 1uF
D1: LED
Q1: BC107; TO-18-3
R1: 1K
R2: 100K
R3, R4, R5: 5
R6: 220
U1: Comparator 2
U2: SR LATCH

Connections:
+5V: Q1.3 (C), R1.1, R3.1
GND: C1.2, Q1.1 (E), R5.2, R6.2
unnamed: C1.1, R2.2, R4.2, R5.1, U1.3 (+), U1.5 (+), U1.6 (-)
unnamed: D1.1 (K), R6.1
unnamed: D1.2 (A), U2.2 (Q)
unnamed: Q1.2 (B), U2.4 (~Q)
unnamed: R1.2, R2.1
unnamed: R3.2, R4.1, U1.2 (-)
unnamed: U1.1, U2.3 (R)
unnamed: U1.7, U2.1 (S)

Notes on the sheet:
555 Timer Model
Pin 7
Pin 6
Output
Pin 2
