uddivert/SAP-U/Sim/Schematic_Sims/555TimerModel_Bistable.kicad_sch

## KiCad design Sim/Schematic_Sims/555TimerModel_Bistable.kicad_sch (2024-10-01)

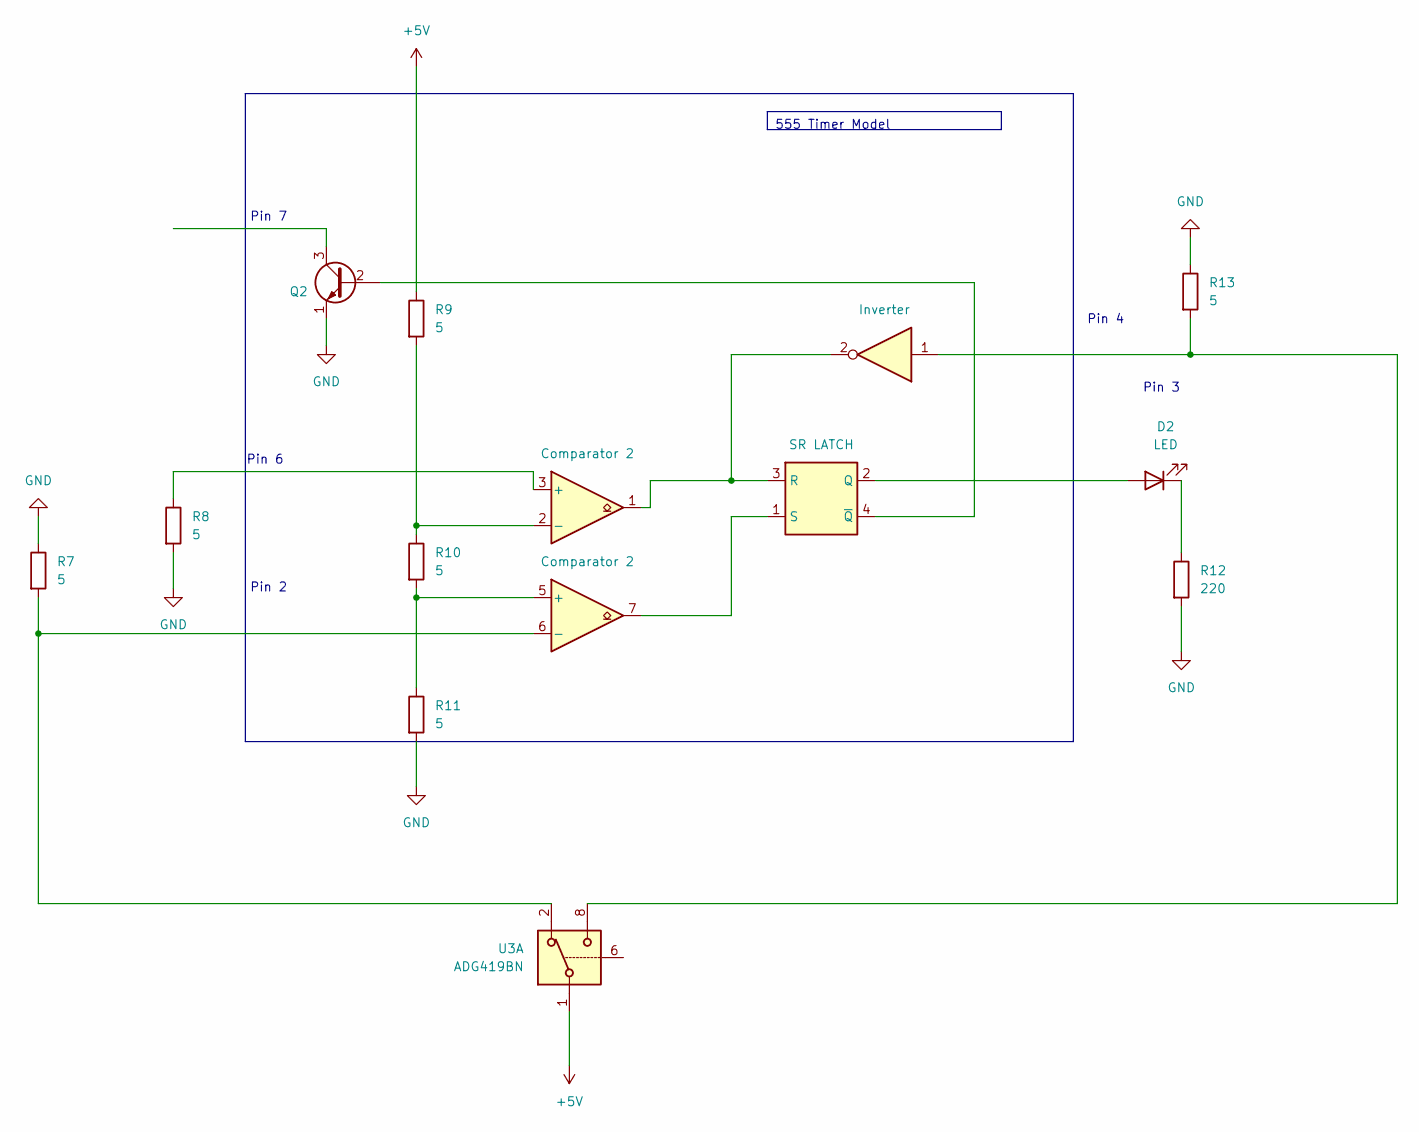
[picture p12: schematic 555TimerModel_Bistable.kicad_sch]

Parts:
D2: LED
Q2: BC107; TO-18-3
R7, R8, R9, R10, R11, R13: 5
R12: 220
U3: ADG419BN; DIP-8_W7.62mm
U4: Comparator 2
U5: SR LATCH
U6: Inverter

Connections:
+5V: R9.1, U3.1
GND: Q2.1 (E), R7.1, R8.2, R11.2, R12.2, R13.1
unnamed: D2.1 (K), R12.1
unnamed: D2.2 (A), U5.2 (Q)
unnamed: Q2.2 (B), U5.4 (~Q)
unnamed: R7.2, U3.2, U4.6 (-)
unnamed: R8.1, U4.3 (+)
unnamed: R9.2, R10.1, U4.2 (-)
unnamed: R10.2, R11.1, U4.5 (+)
unnamed: R13.2, U3.8, U6.1
unnamed: U4.1, U5.3 (R), U6.2
unnamed: U4.7, U5.1 (S)

Notes on the sheet:
555 Timer Model
Pin 7
Pin 6
Pin 3
Pin 2
Pin 4
