uddivert/SAP-U/Sim/Schematic_Sims/555TimerModel_Debounce.kicad_sch

## KiCad design Sim/Schematic_Sims/555TimerModel_Debounce.kicad_sch (2024-10-01)

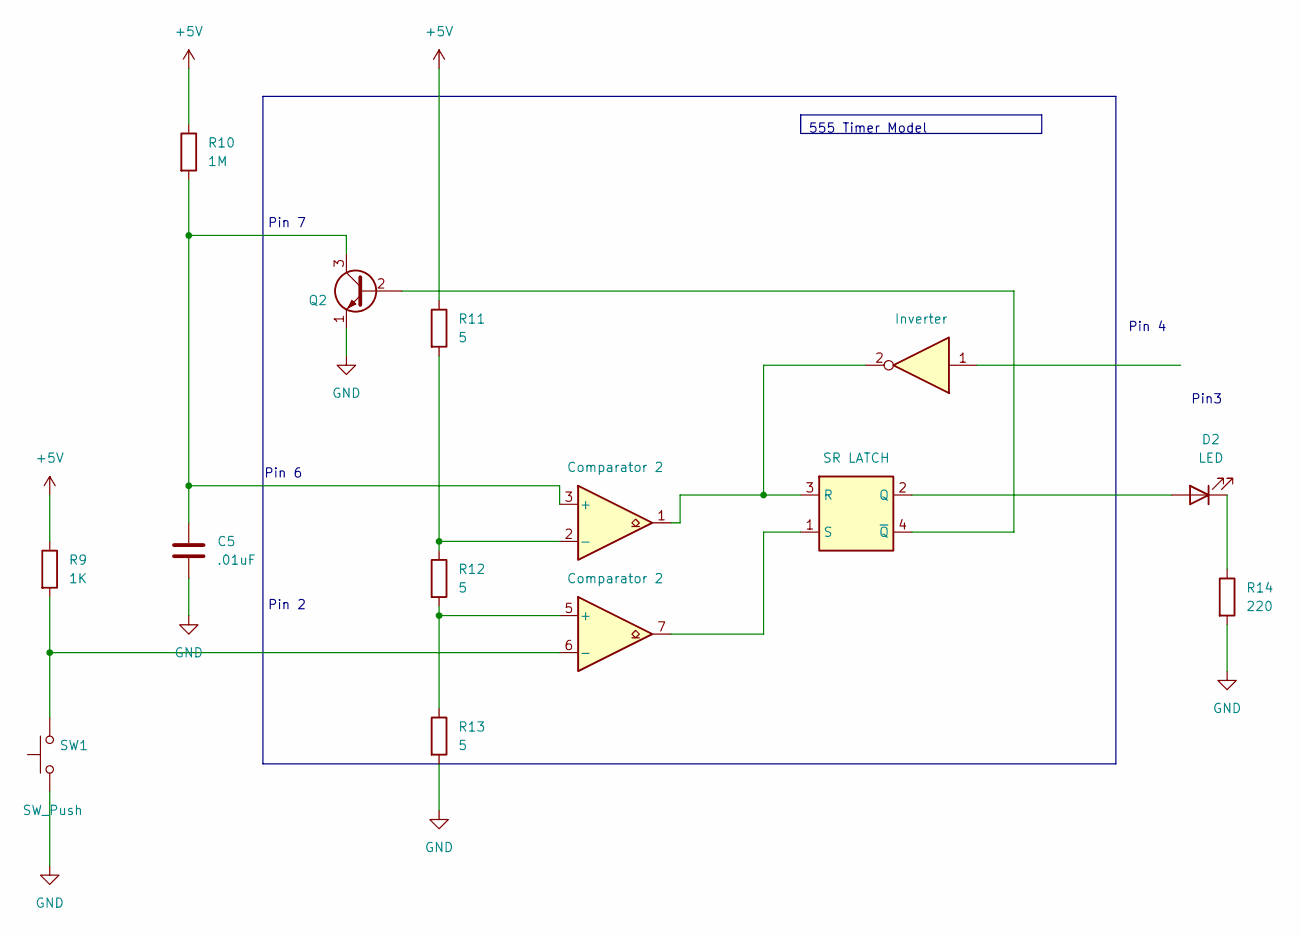
[picture p13: schematic 555TimerModel_Debounce.kicad_sch]

Parts:
C5: .01uF
D2: LED
Q2: BC107; TO-18-3
R9: 1K
R10: 1M
R11, R12, R13: 5
R14: 220
SW1: SW_Push
U4: Comparator 2
U5: SR LATCH
U10: Inverter

Connections:
+5V: R9.1, R10.1, R11.1
GND: C5.2, Q2.1 (E), R13.2, R14.2, SW1.1
unnamed: C5.1, Q2.3 (C), R10.2, U4.3 (+)
unnamed: D2.1 (K), R14.1
unnamed: D2.2 (A), U5.2 (Q)
unnamed: Q2.2 (B), U5.4 (~Q)
unnamed: R9.2, SW1.2, U4.6 (-)
unnamed: R11.2, R12.1, U4.2 (-)
unnamed: R12.2, R13.1, U4.5 (+)
unnamed: U4.7, U5.1 (S)
unnamed: U4.1, U5.3 (R), U10.2

Notes on the sheet:
555 Timer Model
Pin 7
Pin 6
Pin3
Pin 2
Pin 4
