uddivert/SAP-U/Sim/test/modules/SAP_U/SAP_U_tb.v

`timescale 1ns / 1ps

module SAP_U_tb ();
  // System inputs
  reg        clk;  // System clock
  reg        reset;  // System reset

  // Register A
  reg        reg_a_load_n;
  reg        reg_a_bus_enable_n;

  // Register B
  reg        reg_b_load_n;
  reg        reg_b_bus_enable_n;

  // ALU
  reg        alu_enable_n;
  reg        alu_subtract;

  // RAM
  reg  [7:0] ram_dipswitch_data;
  reg  [3:0] ram_dipswitch_addr;
  reg        ram_addr_select;
  reg        ram_prog_mode;
  reg        ram_bus_enable_n;
  reg        ram_write_enable_n;
  reg        ram_control_signal;
  reg        ram_load_mar_reg_n;
  reg        ram_clear_mar_reg;

  // Program Counter

  reg        program_counter_clear_n;
  reg        program_counter_enable;
  reg        jump_n;
  reg        program_counter_bus_enable_n;
  wire [3:0] instruction_pointer;

  // Bus
  reg  [7:0] data_bus_in;


  SAP_U uut (
      // System inputs
      .clk  (clk),   // System clock
      .reset(reset), // System reset

      // Register A
      .reg_a_load_n(reg_a_load_n),  // Load signal
      .reg_a_bus_enable_n(reg_a_bus_enable_n),  // Enable signal

      // Register B
      .reg_b_load_n(reg_b_load_n),  // Load signal
      .reg_b_bus_enable_n(reg_b_bus_enable_n),  // Enable signal

      // ALU
      .alu_enable_n(alu_enable_n),  // Lets ALU output to bus
      .alu_subtract(alu_subtract),

      // Ram
      .ram_dipswitch_data(ram_dipswitch_data),
      .ram_dipswitch_addr(ram_dipswitch_addr),
      .ram_addr_select(ram_addr_select),
      .ram_prog_mode(ram_prog_mode),
      .ram_write_enable_n(ram_write_enable_n),
      .ram_bus_enable_n(ram_bus_enable_n),
      .ram_control_signal(ram_control_signal),
      .ram_load_mar_reg_n(ram_load_mar_reg_n),
      .ram_clear_mar_reg(ram_clear_mar_reg),

      // Program Counter
      .program_counter_clear_n(program_counter_clear_n),
      .program_counter_enable(program_counter_enable),
      .jump_n(jump_n),
      .program_counter_bus_enable_n(program_counter_bus_enable_n),
      .instruction_pointer(instruction_pointer),

      // Bus Manager
      .data_bus_in(data_bus_in)
  );

  // Clock generation: 50% duty cycle with a period of 10 time units
  initial begin
    clk = 0;
    forever #5 clk = ~clk;  // 10ns clock period
  end

  initial begin
    $dumpfile("./simulation/testbench_master.vcd");  // VCD file for waveform generation
    $dumpvars(0, SAP_U_tb);

    // Enable Program Counter. Set jump to off
    jump_n = 1;
    program_counter_enable = 1;
    program_counter_bus_enable_n = 1;

    // allow data to be loaded into register
    data_bus_in = 8'b0;
    reg_a_load_n = 0;
    reg_b_load_n = 0;

    reg_a_bus_enable_n = 1;
    reg_b_bus_enable_n = 1;
    ram_bus_enable_n = 1;
    alu_enable_n = 0;  // Enable ALU output to bus
    reset = 0;
    #10

    // stop registers from writing to bus
    alu_subtract = 0;  // Addition Mode
    #10;

    // test subtraction
    alu_subtract = 1;
    #10 alu_enable_n = 1;  // Disable ALU output to bus
    #10

    // Test Ram
    ram_dipswitch_data = 8'h0;
    ram_dipswitch_addr = 4'h0;
    ram_addr_select    = 1;  // load address from dipswitch
    ram_prog_mode      = 0;  // set to dipswitch_data
    ram_control_signal = 0;  // Don't read data from bus
    ram_load_mar_reg_n = 0;  // load address
    ram_clear_mar_reg  = 0;  // clear mar
    ram_bus_enable_n   = 0;  // enable output to bus
    #5

    // Set dipswich data to 1 and write to address 0
    ram_load_mar_reg_n = 1;  // stop loading address
    ram_dipswitch_data = 8'b00000001;
    ram_write_enable_n = 0;
    #1 ram_write_enable_n = 1;
    #9;

    // write ram data from bus
    ram_prog_mode = 1;
    ram_control_signal = 1;
    #10 ram_bus_enable_n = 1;  // disable output to bus
    #10

    // Test Program Counter

    // Enable bus
    program_counter_bus_enable_n = 0;
    #10

    // Clear prgram counter
    program_counter_clear_n = 0;
    #10 program_counter_clear_n = 1;
    #10

    // Count up
    repeat (5)
    @(posedge clk);

    // jump
    data_bus_in = 4'b0101;
    jump_n = 0;
    #5;  // short active-low pulse
    jump_n = 1;
    #20;
    repeat (4) @(posedge clk);

    // Disable bus
    program_counter_bus_enable_n = 1;
    #10 $finish;
  end
endmodule
