uddivert/SAP-U/Sim/hdl/modules/instruction_register.v

// Difference from circuit board's implementaton
// Using the sn54173's for output control
//
// This is because we don't need the 74LS24 octal bus transciever
// to go between the sn54173 to see the output
//
// Identical to A and B register. Top 4 bits are NOT output back onto the bus
`default_nettype none
module instruction_register (
    input wire load,
    input wire enable,
    input wire clr,
    input wire clk,
    input wire [7:0] data,
    output wire [3:0] q
);
  sn54173_quad_flip_flop sn54173_1 (
      .m(enable),
      .n(enable),
      .g1(load),
      .g2(load),
      .clr(clr),
      .clk(clk),
      .data(data[3:0]),  // lower 4 bits of data
      .q(q[3:0])  // lower 4 bits of q
  );
  sn54173_quad_flip_flop sn54173_2 (
      .m(enable),
      .n(enable),
      .g1(load),
      .g2(load),
      .clr(clr),
      .clk(clk),
      .data(data[7:4])  // upper 4 bits of data
  );
endmodule
