uddivert/SAP-U/(commit log)

2024-09-17 first commit: added wiki and project files
    [555TimerModel.kicad_sch, Clock_Module.kicad_sch, SAP-U_Project.kicad_pcb, SAP-U_Project.kicad_sch]
2024-09-18 Checkpoint: created documentation and schematic for the astable portion of the clock module
    [555TimerModel.kicad_sch, Clock_Module.kicad_sch]
2024-09-22 added circuit for monostable clock
    [555TimerModel_Astable.kicad_sch, 555TimerModel_Debounce.kicad_sch, Clock_Module.kicad_sch]
2024-09-23 Checkpoint: added circuit for Bistable
    [555TimerModel_Astable.kicad_sch, 555TimerModel_Bistable.kicad_sch, Clock_Module.kicad_sch]
2024-09-24 Checkpoint: added switching logic
    [555TimerModel_Astable.kicad_sch, 555TimerModel_Bistable.kicad_sch, 555TimerModel_Debounce.kicad_sch, Clock_Module.kicad_sch]
2024-10-01 Checkpoint: moved simulations to new kicad project
    [555TimerModel.kicad_sch, 555TimerModel_Astable.kicad_sch, 555TimerModel_Bistable.kicad_sch, 555TimerModel_Debounce.kicad_sch, Schematic_Sims.kicad_pcb, Schematic_Sims.kicad_sch]
2024-10-02 Checkpoint: fixed ERC errors
    [555TimerModel.kicad_sch, 555TimerModel_Astable.kicad_sch, 555TimerModel_Bistable.kicad_sch, 555TimerModel_Debounce.kicad_sch, Clock_Module.kicad_sch]
2024-10-02 cleaned up circuit for bistable, monostable, and astable circuits
    [Clock_Module.kicad_sch]
2024-10-03 Checkpoint: completed schematic for Clock Module
    [Clock_Module.kicad_sch, No_Connects.kicad_sch, SAP-U_Project.kicad_sch]
2024-10-03 Checkpoint: Linked footprints to schematics
    [Clock_Module.kicad_sch, No_Connects.kicad_sch, SAP-U_Project.kicad_pcb]
2024-10-08 Checkpoint: added 555 timer simulation library
    [Clock_Module.kicad_sch]
2024-10-08 Checkpoint: removed simulation, cleaned up schematic
    [Clock_Module.kicad_sch, No_Connects.kicad_sch, SAP-U_Project.kicad_sch]
2024-10-09 Checkpoint: cleaned up clock module. Made one schematic. Good stop point
    [Clock_Module.kicad_pcb, Clock_Module.kicad_sch, SAP-U_Project.kicad_sch]
2024-10-16 Checkpoint: Added reset to d_flip_flop and updated testbench
    [d_flip_flop.v]
2024-10-17 added reset, fixed time scale, fixed 1 bit register
    [d_flip_flop.v, sn54173_quad_flip_flop.v]
2024-10-21 Updated Schematic to PC104 standards, updated Simulation for intel-quartus, updated PCB constraints, and edited board layout
    [Clock_Module.kicad_pcb, Clock_Module.kicad_sch]
2024-10-22 partially complete pcb and updated schematic with bypass capacitors
    [Clock_Module.kicad_pcb, Clock_Module.kicad_sch]
2024-10-23 Routed PCB
    [Clock_Module.kicad_pcb, Clock_Module.kicad_sch]
2024-10-30 completed clock module
    [Clock_Module.kicad_pcb, Clock_Module.kicad_sch]
2024-11-12 Added boilerplate for ALU
    [Arithmetic_Logic_Unit.kicad_pcb, Arithmetic_Logic_Unit.kicad_sch, Register_sch.kicad_sch]
2024-11-12 added A, B, and Instructional Regsiters
    [Arithmetic_Logic_Unit.kicad_sch, Instructional_Register.kicad_sch]
2024-11-14 updated wiki, created board outline for alu, made registers with hierarchical label
    [Arithmetic_Logic_Unit.kicad_pcb, Arithmetic_Logic_Unit.kicad_sch, Instructional_Register.kicad_sch, Register_sch.kicad_sch]
2024-11-23 fixed variables in dm74ls283 and added alu logic
    [alu.v, dm74ls283_quad_adder.v]
2024-11-24 updated tests, fixed alu
    [alu.v]
2024-11-24 wire top module and added testbench
2024-11-24 fixed register schematic
    [Arithmetic_Logic_Unit.kicad_sch, Instructional_Register.kicad_sch, Register_sch.kicad_sch]
2024-11-25 completed alu schematic with errors
    [Arithmetic_Logic_Unit.kicad_sch, Instructional_Register.kicad_sch, Register_sch.kicad_sch]
2024-11-26 removed buses and replaced with hierarchical labels
    [Arithmetic_Logic_Unit.kicad_sch, Register_sch.kicad_sch]
2024-11-27 added instructional register
    [ALU.kicad_sch, Arithmetic_Logic_Unit.kicad_sch, ir.kicad_sch]
2024-11-28 added flags
    [ALU.kicad_sch, Arithmetic_Logic_Unit.kicad_sch]
2024-12-08 fixed incorrect footprint for sn54173
    [ALU.kicad_sch, Arithmetic_Logic_Unit.kicad_sch, Register_sch.kicad_sch, ir.kicad_sch]
2024-12-09 fixed wiring issues
    [ALU.kicad_sch, Register_sch.kicad_sch]
2024-12-09 added bypass capacitors
    [ALU.kicad_sch, Arithmetic_Logic_Unit.kicad_sch, Register_sch.kicad_sch, ir.kicad_sch]
2024-12-09 preliminary board layout, will move IR to clock module
    [ALU.kicad_sch, Arithmetic_Logic_Unit.kicad_pcb, Register_sch.kicad_sch, ir.kicad_sch]
2024-12-10 layed out PCB
    [ALU.kicad_sch, Arithmetic_Logic_Unit.kicad_pcb, Arithmetic_Logic_Unit.kicad_sch, Register_sch.kicad_sch]
2024-12-26 Placed clock module again
    [ALU.kicad_sch, Clock_Module.kicad_pcb, Clock_Module.kicad_sch, Instructional_Register.kicad_sch, Register_sch.kicad_sch, clock.kicad_sch, instruction_register.kicad_sch]
2024-12-27 Updated Clock Module Schematic, and moved Instruction Register to new board
    [Clock_Module.kicad_pcb, Clock_Module.kicad_sch, Instruction_Register.kicad_pcb, Instruction_Register.kicad_sch, clock.kicad_sch, instruction_register.kicad_sch]
2024-12-29 mostly routed IR, fixed logic issue in Clock Module
    [Clock_Module.kicad_pcb, Instruction_Register.kicad_pcb, Instruction_Register.kicad_sch, clock.kicad_sch]
2025-01-01 returning to pc104 standard
    [Arithmetic_Logic_Unit.kicad_sch, Clock_Module.kicad_pcb, Clock_Module.kicad_sch, Instruction_Register.kicad_pcb, Instruction_Register.kicad_sch, Register_sch.kicad_sch]
2025-01-03 fixed clock module, made it back into pc104 board standard
    [Clock_Module.kicad_pcb, Clock_Module.kicad_sch, clock.kicad_sch]
2025-01-04 updated instruction register to match pc104
    [Instruction_Register.kicad_pcb, Instruction_Register.kicad_sch]
2025-01-04 updated Sim files
    [c5_pin_model_dump.txt]
2025-02-03 updated registers and alu
    [ALU.kicad_sch, Arithmetic_Logic_Unit.kicad_pcb, Register_sch.kicad_sch, Registers_Module.kicad_pcb, Registers_Module.kicad_sch]
2025-02-11 placeholder files for new Simulation structure
    [c5_pin_model_dump.txt]
2025-02-27 fixed sn74ls159 testbench, linting, and formatting
    [common_tb.v]
2025-03-20 fixed incorrect module name
    [common_tb.v, ram.v, sn74ls157.v]
2025-03-26 fixed ram compilation issue
    [ram.v]
2025-03-26 added ram testbench.. Doesn't work...
    [ram.v, ram_tb.v]
2025-03-31 fixed ram not using correct signal
    [ram.v]
2025-03-31 added comments. Still fixing ram
    [f189.v, ram.v, ram_tb.v]
2025-04-01 fixed ram inverting output error
    [memory.v, ram_tb.v]
2025-04-02 temporary fix to f189 module so it is async. Need to rewrite properly without always @ block
    [f189.v, ram.v]
2025-06-02 sim going through major revisions
    [Clock_Module.kicad_pcb, Clock_Module.kicad_sch, clock.kicad_sch]
2025-06-09 added enables to Bus Manager. Need to fix ram. Can write to bus with ALU
    [SAP_U.v, SAP_U_tb.v, alu.v, alu_tb.v]
2025-06-09 control logic not working again
    [f189.v, memory.v, memory_tb.v, ram.v, ram_tb.v]
2025-06-09 fixed control signal in ram
    [ram.v, ram_tb.v]
2025-06-10 formatting, ram prints to bus
2025-07-22 added cap's between power pins
    [ALU.kicad_sch, Register_sch.kicad_sch, Registers_Module.kicad_sch]
2025-07-26 updated Arithemetic Logic Unit
    [ALU.kicad_sch, Arithmetic_Logic_Unit.kicad_sch, Instruction_Register.kicad_sch, Register_sch.kicad_sch]
2025-07-26 Removed Register schematic from ALU & created Memory Address Register
    [Mar.kicad_sch, RAM_Module.kicad_pcb, RAM_Module.kicad_sch, Ram.kicad_sch, Register_sch.kicad_sch]
2025-07-29 added buses for addresses. RAM WIP
    [Mar.kicad_sch, RAM_Module.kicad_sch, Ram.kicad_sch, SOIC16_9P9X3P9_ONS.step]
2025-07-30 connected internal memory
    [Ram.kicad_sch]
2025-07-31 updated RAM, changed bus alignment in ALU, RAM, and registers
    [Arithmetic_Logic_Unit.kicad_sch, Instruction_Register.kicad_sch, RAM_Module.kicad_sch, Ram.kicad_sch, Register_sch.kicad_sch, Registers_Module.kicad_sch]
2025-08-01 connected RAM
    [Ram.kicad_sch]
2025-08-04 fixed Ram register, fixed mar in ram.v, updated caps in alu, ram, and instruction register
    [ALU.kicad_sch, Instruction_Register.kicad_sch, Mar.kicad_sch, RAM_Module.kicad_sch, Ram.kicad_sch, Register_sch.kicad_sch]
2025-08-05 need to fix and add master_slave jkff
    [common_tb.v, dm7476_jk_flip_flop.v]
2025-08-26 formatting, linting, and fixed bus for program counter in SAP_U_tb.v
    [SAP_U.v, SAP_U_tb.v, alu.v, d_latch.v, dm7476_jk_flip_flop.v, f189.v, jk_flip_flop.v, memory.v]
2025-08-26 Added Program Counter Schematic
    [Mar.kicad_sch, Program_Counter.kicad_pcb, Program_Counter.kicad_sch, Ram.kicad_sch]
